FadiHaniHanna/Multi-Robot-Formation-Control-System-for-Cooperative-Warehouse-Transportation/images/Implementation Screenshots.png

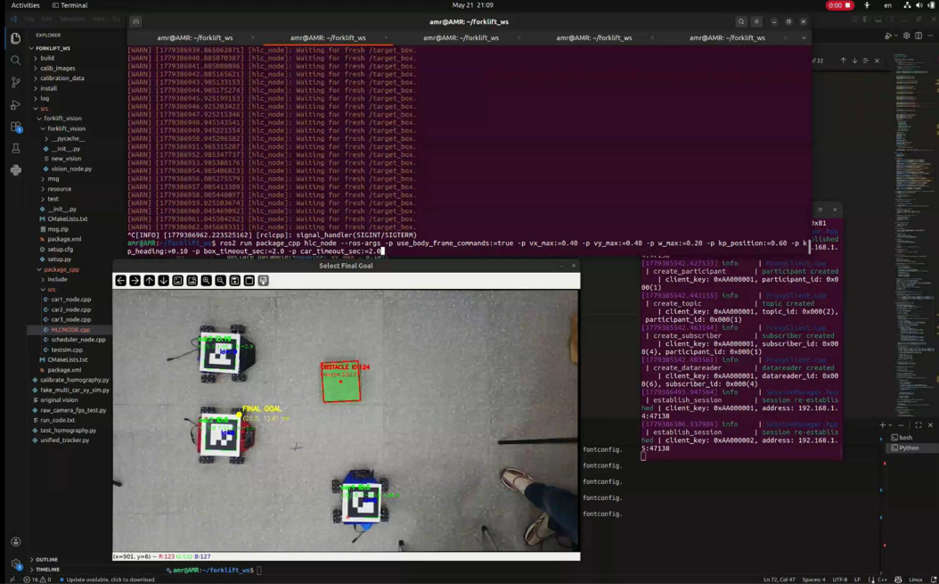
images/Implementation Screenshots.png
