FadiHaniHanna/Multi-Robot-Formation-Control-System-for-Cooperative-Warehouse-Transportation/images/Simulation Using ROS2.png

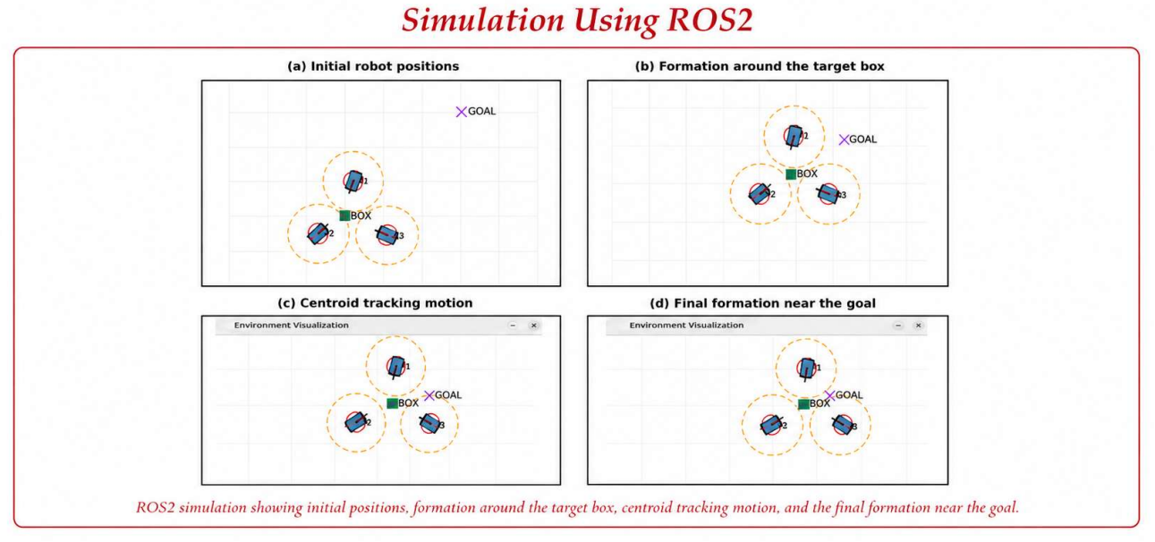
images/Simulation Using ROS2.png
