FadiHaniHanna/Multi-Robot-Formation-Control-System-for-Cooperative-Warehouse-Transportation/images/Warehouse.png

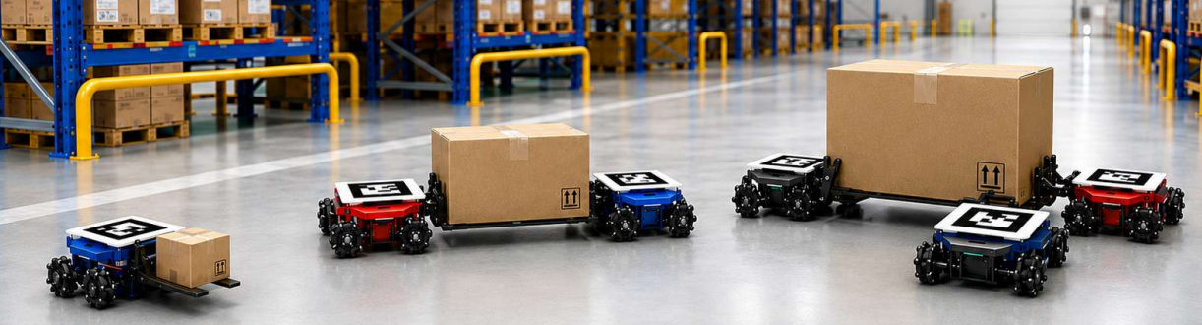
images/Warehouse.png
